pswam-17/FrisbeeSpinDetection/ECE 16 Poster - Team K.pptx.pdf

# ECE 16 Team K - Ultimate Frisbee Development

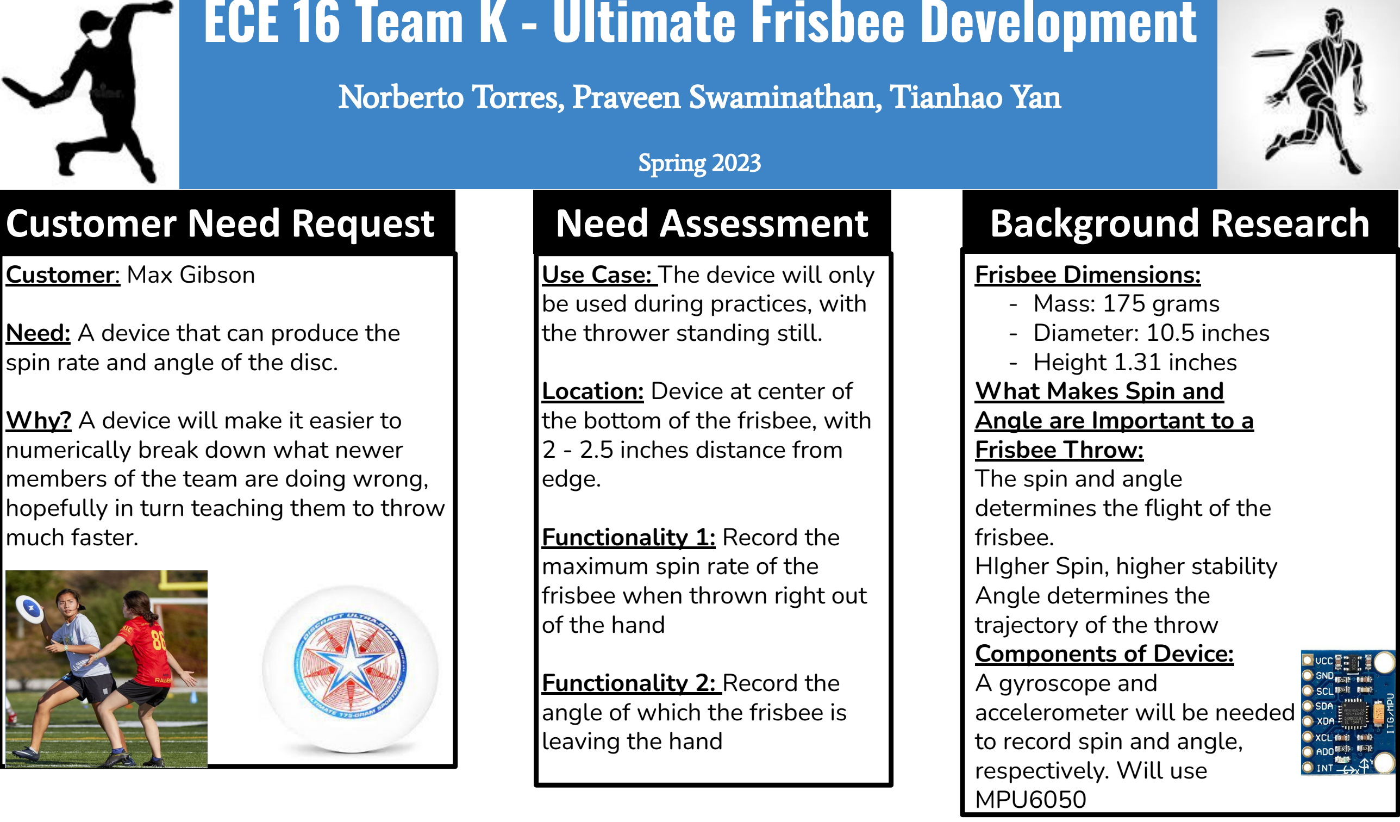
[picture p8: figure]
Spring 2023; Customer: Max Gibson; Need: A device that can produce the spin rate and angle of the disc.; Why? A device will make it easier to numerically break down what newer members of the team are doing wrong,; much faster.; Use Case: The device will only be used during practices, with the thrower standing still.; Location: Device at center of the bottom of the frisbee, with 2 - 2.5 inches distance from edge.; Functionality 1: Record the maximum spin rate of the frisbee when thrown right out of the hand; Functionality 2: Record the angle of which the frisbee is leaving the hand; Frisbee Dimensions: - Mass: 175 grams - Diameter: 10.5 inches - Height 1.31 inches What Makes Spin and Angle are Important to a Frisbee Throw: The spin and angle determines the flight of the frisbee. HIgher Spin, higher stability Angle determines the trajectory of the throw Components of Device: A gyroscope and accelerometer will be needed to record spin and angle, respectively. Will use MPU6050

### Norberto Torres, Praveen Swaminathan, Tianhao Yan

Customer Need Request | Need Assessment | Background Research
Solution Proposal | Development Plan

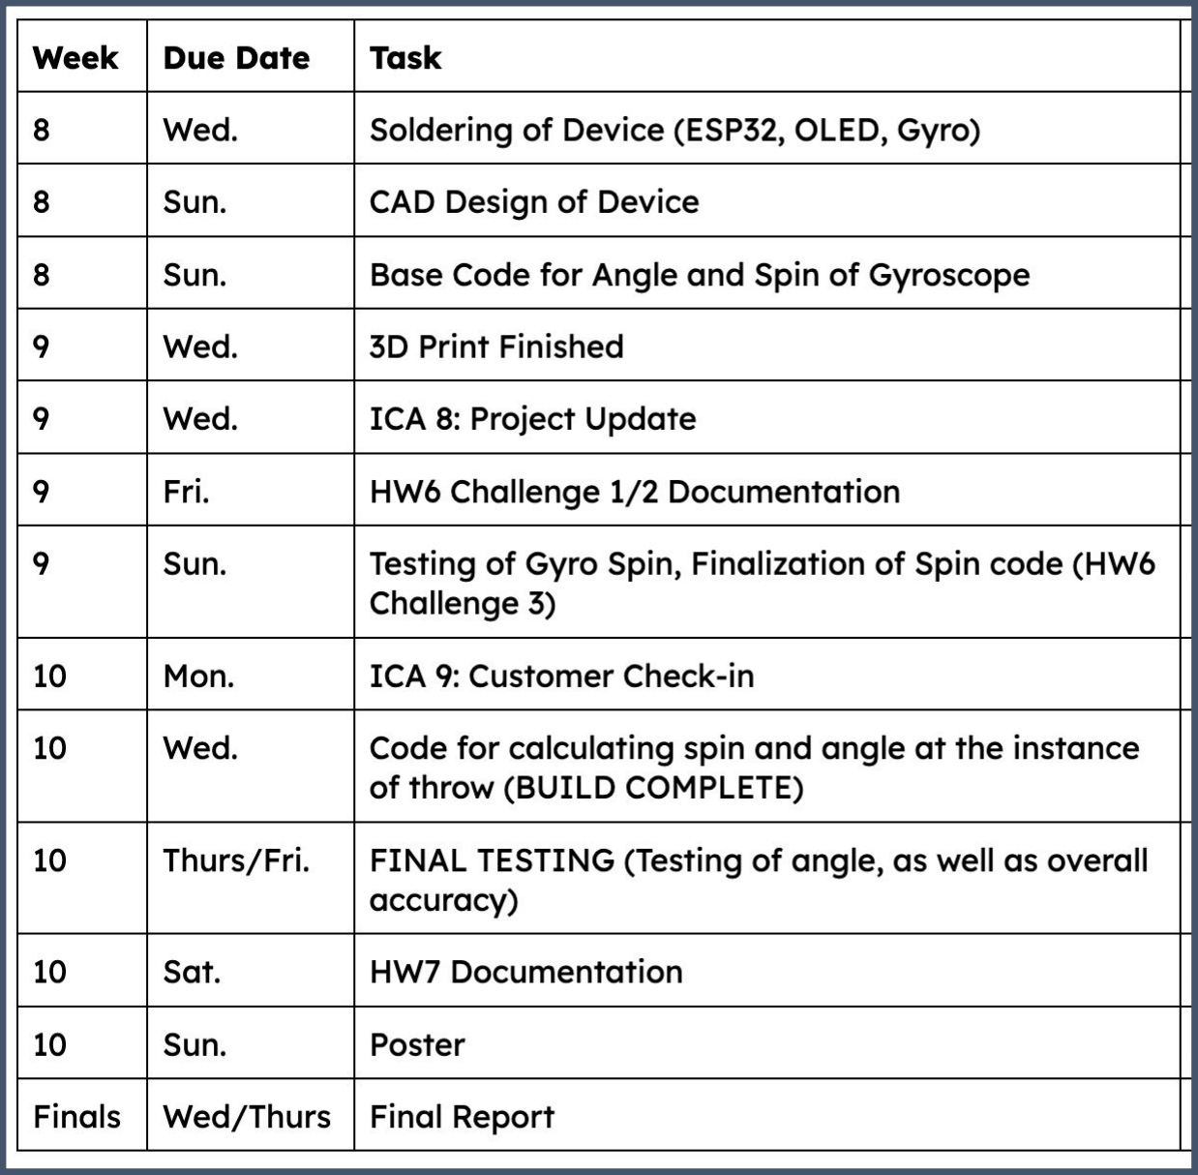
[picture p9: figure]
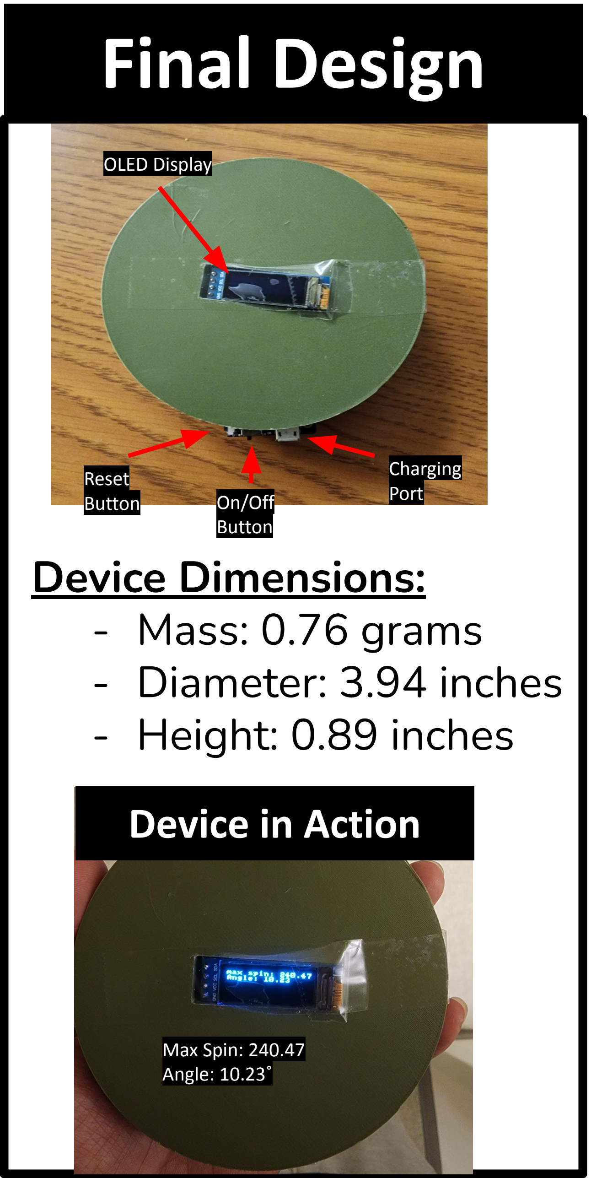
[picture p10: figure]
Device Dimensions: - Mass: 0.76 grams - Diameter: 3.94 inches - Height: 0.89 inches; OLED Display; Reset Button; Charging Port On/Off; Button; Device in Action; Max Spin: 240.47 Angle: 10.23˚

System Testing & Validation | Final Design | Challenges and Limitations

hopefully in turn teaching them to throw

### Design Alternatives

Bluetooth
considered, but
given the need of
our customer, NOT
essential to final
design.
Use of TTGO T7
V1.3 instead of
Nano, and a 3V
LiPo Battery to
make overall device
lighter

Features For The Device That Was Proposed Based On The Customer Needs:
- Will be mountable and can be detached on the frisbee
- Will be light to not affect the throw and also circular to not alter the hand placement and not give discomfort to the thrower.
- Will have an OLED display to show the maximum spin and
instant angle of throw.

Angle Calculation:
- A protractor is used to calculate the angle of the frisbee when stationary. Then the display on the OLED is compared with the result from the protractor.
Max Spin:
- We put a marker on the frisbee and use a slow motion camera to film the throw. Since the spin slows down over time, we calculate the time it takes to complete the first two revolutions, and convert the result into RPM in order to comparing to the displayed max spin on the device.

Limitations:
- The first is that in order to receive the most accurate result, the throw can't be made in a fluid motion. Rather, the user needs to go into throwing position, before the angle is detected.
- Secondly, the device cannot measure more than 333 rpm, because the gyroscope itself can only detect 2000 deg/s of rotation. Unfortunately, we learned that most commercial gyroscopes are within this range, and nothing more.

Challenges:
- The main challenge we faced was calculating the angle of throw, with finding an equation that calculates the tilt angle from the sensor parameters, to also readjusting the code for each iteration to account the limitation of the sensor when calculating the angle.

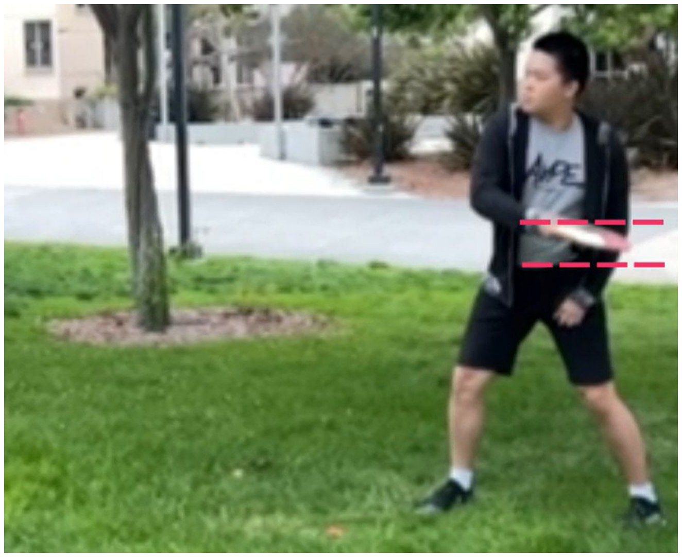
[picture p11: figure]
