pswam-17/FrisbeeSpinDetection/FrisbeeSpinDetection/Documentation/Initial_Design_Base.jpg

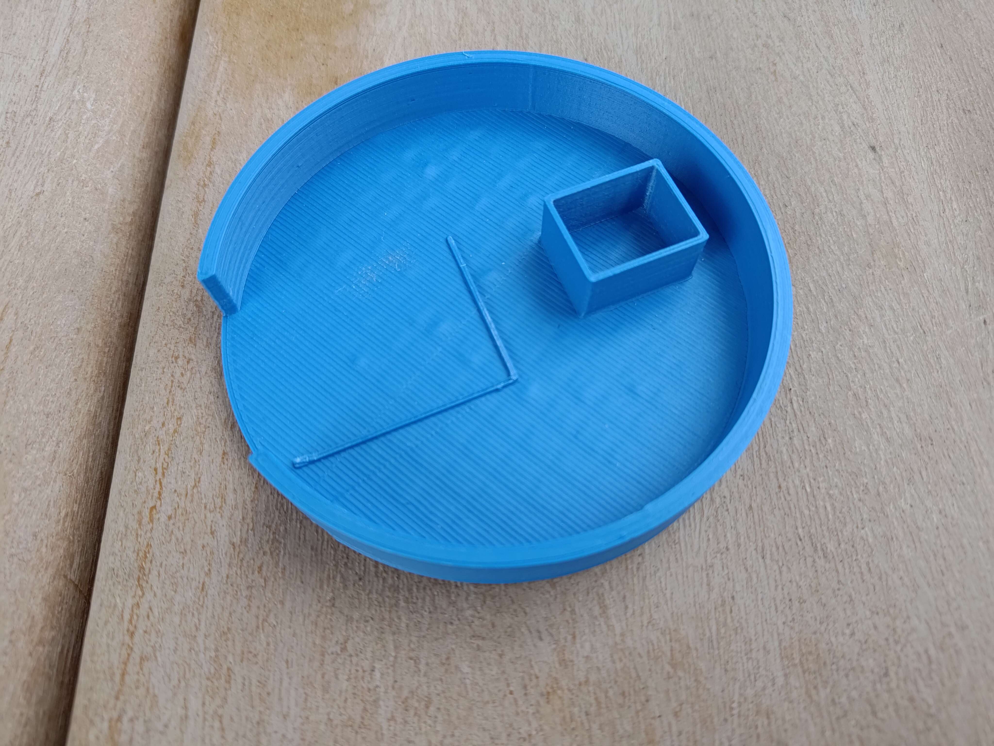
FrisbeeSpinDetection/Documentation/Initial_Design_Base.jpg
