pswam-17/FrisbeeSpinDetection/FrisbeeSpinDetection/Documentation/ProtoInside.jpg

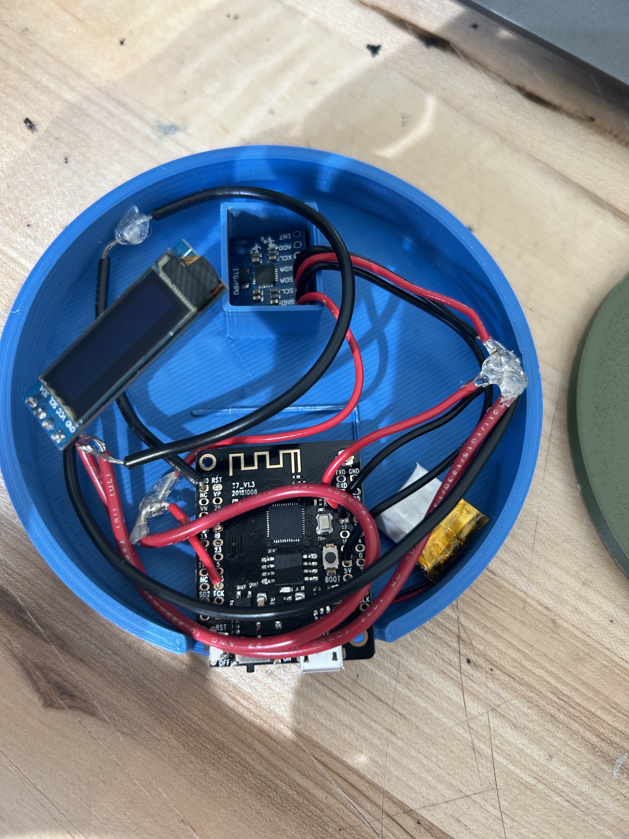
[picture p3: FrisbeeSpinDetection/Documentation/ProtoInside.jpg]
FrisbeeSpinDetection/Documentation/ProtoInside.jpg
